RaulMedina-Estrada143/Phase_C_Deliverables/PCB Designs/PLOT/Plot/3D Render_Back.png

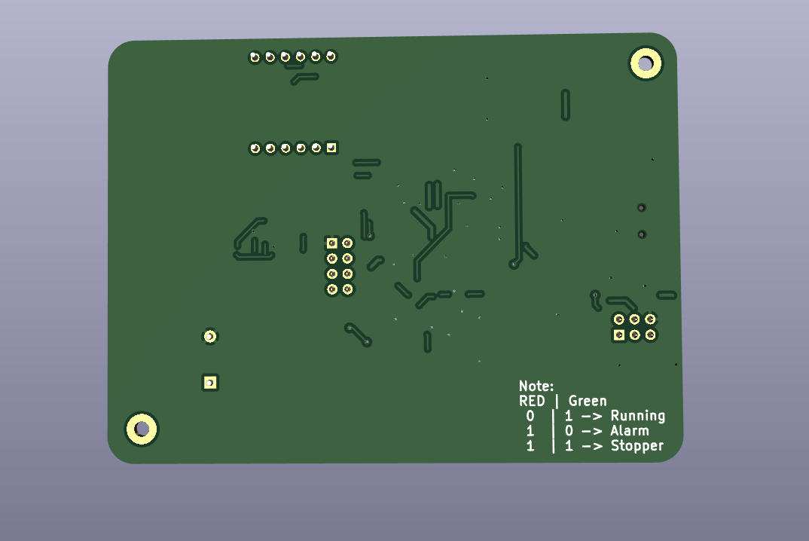
PCB Designs/PLOT/Plot/3D Render_Back.png
