RaulMedina-Estrada143/Phase_C_Deliverables/PCB Designs/PLOT/Plot/PCB_Layout.png

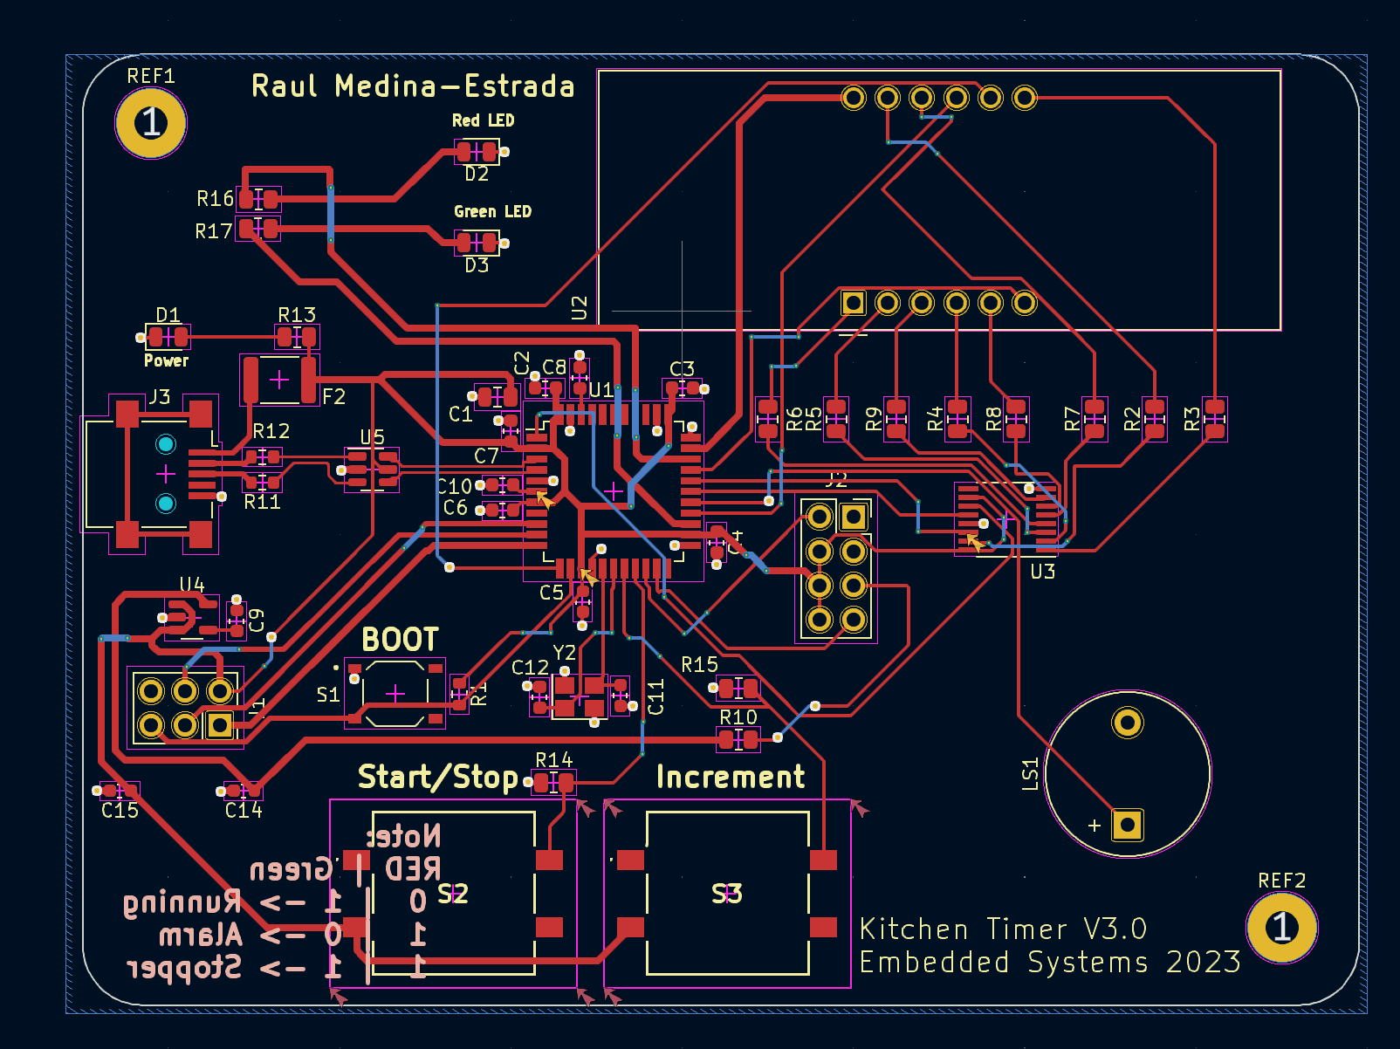
PCB Designs/PLOT/Plot/PCB_Layout.png
