RaulMedina-Estrada143/Phase_C_Deliverables/PCB Designs/PLOT/Plot/Schematic.png

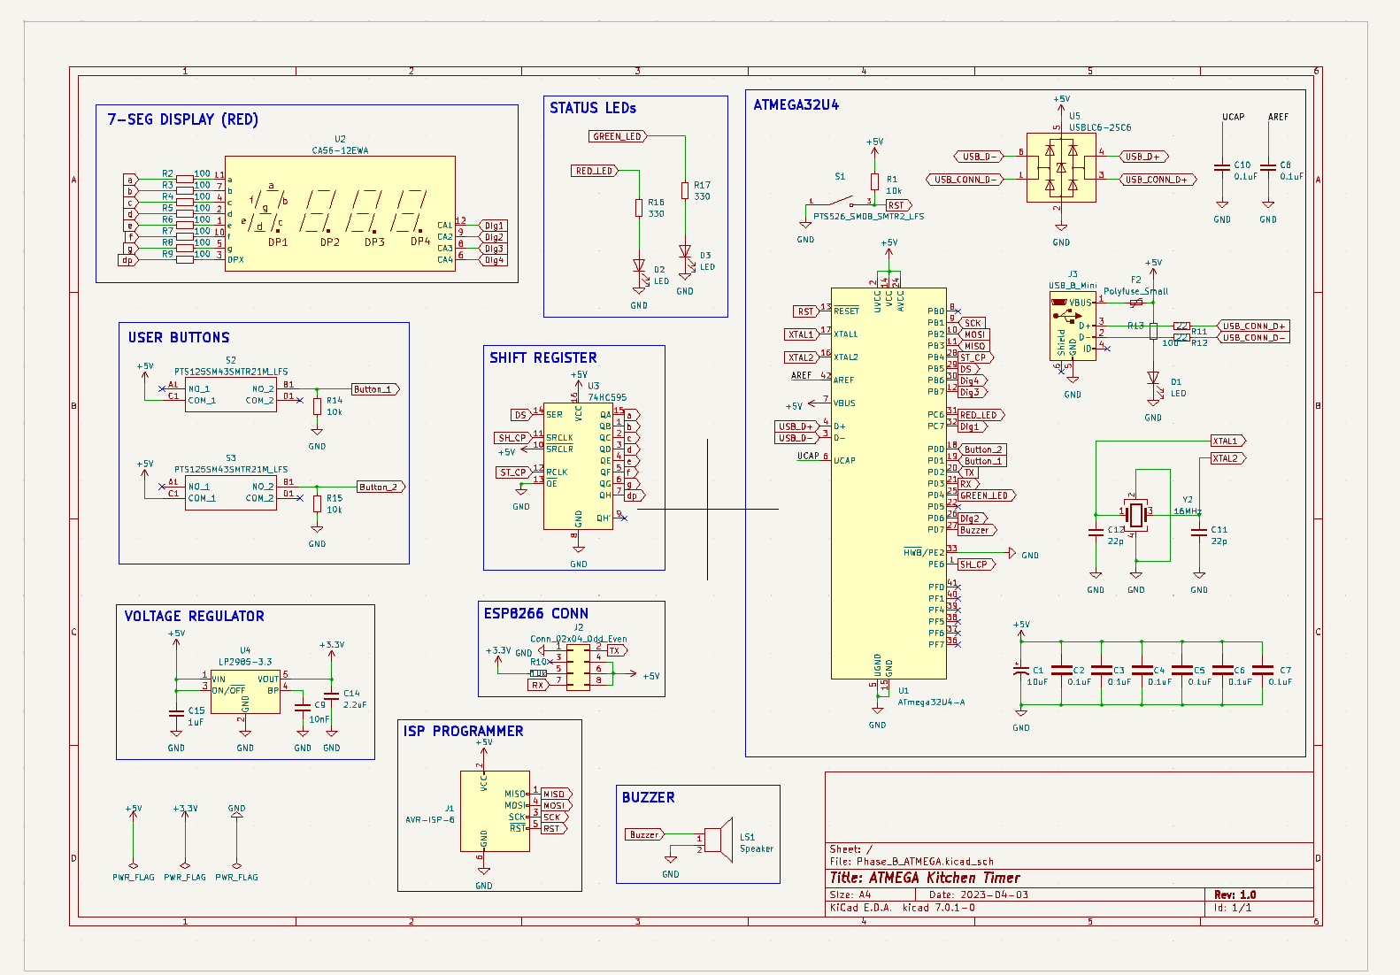
PCB Designs/PLOT/Plot/Schematic.png
