RaulMedina-Estrada143/Phase_C_Deliverables/PCB Designs/ENCLOSURE/KT_ENCLOSURE-top.STL

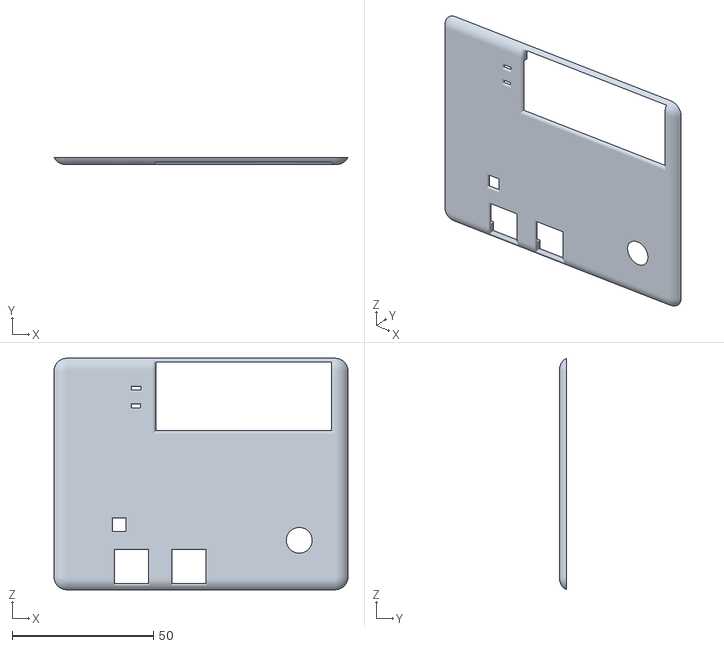
[picture p5: CAD file, 2023-06-13]
PCB Designs/ENCLOSURE/KT_ENCLOSURE-top.STL
104.1 x 2.54 x 82.0
