RaulMedina-Estrada143/Phase_C_Deliverables/PCB Designs/ENCLOSURE/KT_ENCLOSURE.STL

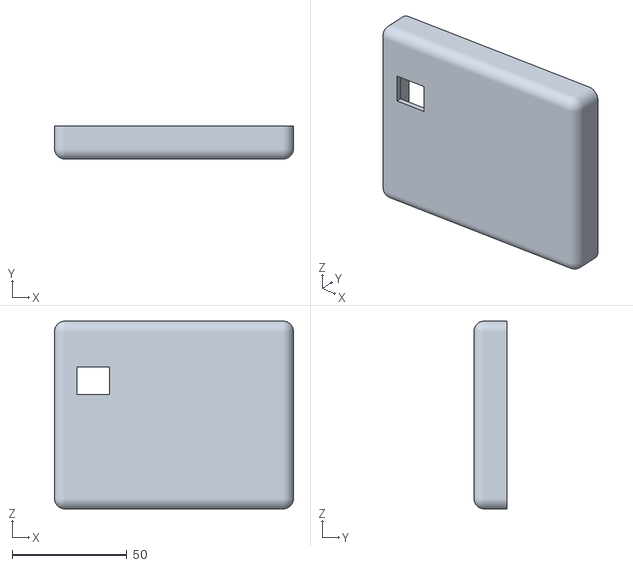
[picture p6: CAD file, 2023-06-13]
PCB Designs/ENCLOSURE/KT_ENCLOSURE.STL
104.2 x 14.5 x 81.9
