RaulMedina-Estrada143/Phase_C_Deliverables/PCB Designs/SCHEMATIC/Phase_B_ATMEGA.kicad_sch

## KiCad design PCB Designs/SCHEMATIC/Phase_B_ATMEGA.kicad_sch (2023-06-13)

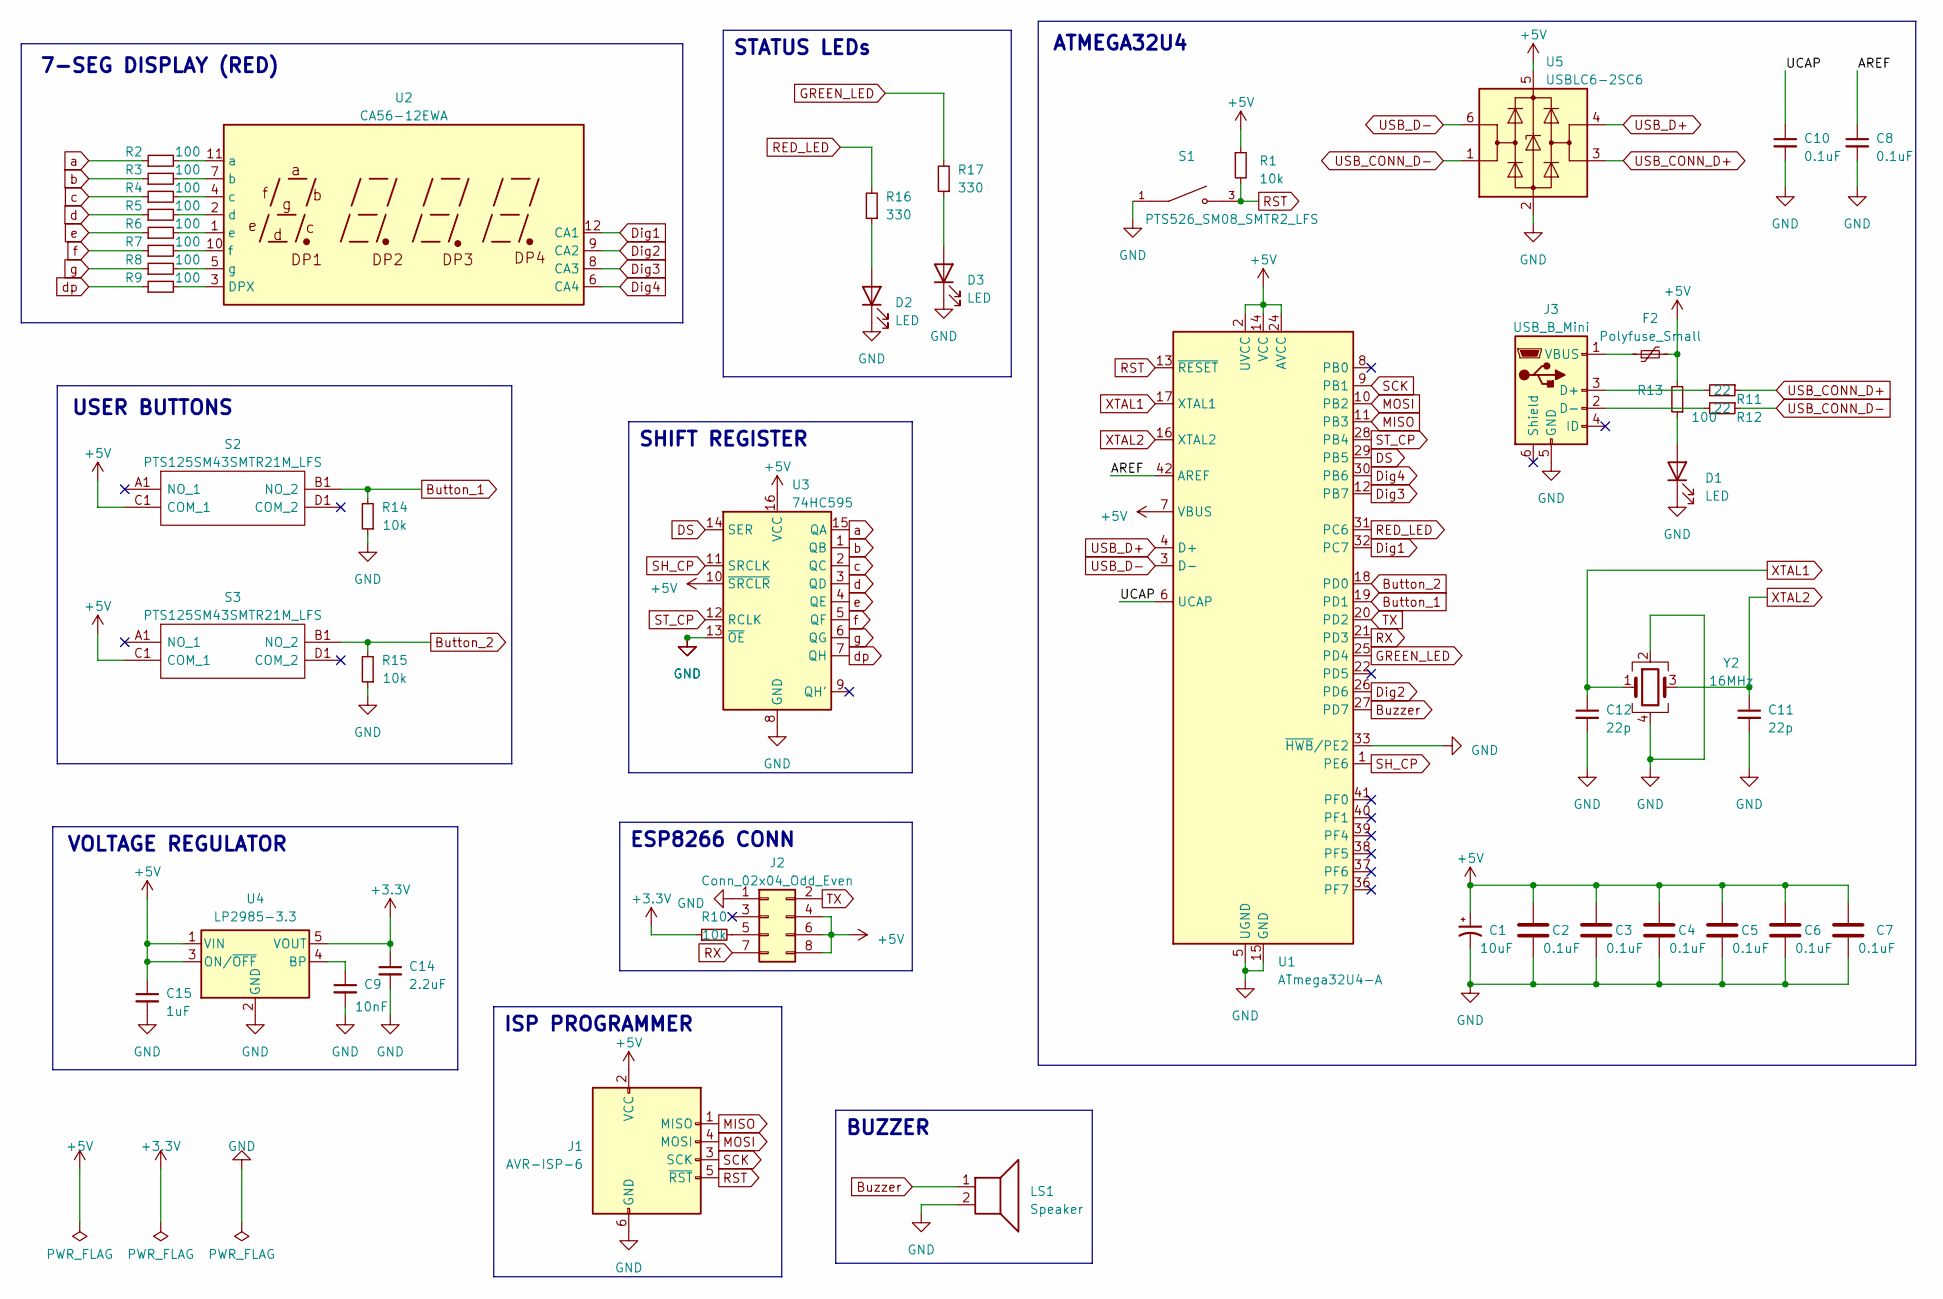
[picture p7: schematic Phase_B_ATMEGA.kicad_sch]

Parts:
C1: 10uF; C_0805_2012Metric
C2, C3, C4, C5, C6, C7, C8, C10: 0.1uF; C_0603_1608Metric
C9: 10nF; C_0603_1608Metric
C11, C12: 22p; C_0603_1608Metric
C14: 2.2uF; C_0603_1608Metric
C15: 1uF; C_0603_1608Metric
D1, D2, D3: LED; LED_0805_2012Metric
F2: Polyfuse_Small; Fuse_1812_4532Metric
J1: AVR-ISP-6; PinSocket_2x03_P2.54mm_Vertical
J2: Conn_02x04_Odd_Even; PinSocket_2x04_P2.54mm_Vertical
J3: USB_B_Mini; USB_Mini-B_Lumberg_2486_01_Horizontal
LS1: Speaker; Buzzer_12x9.5RM7.6
R1: 10k; R_0603_1608Metric
R2, R3, R4, R5, R6, R7, R8, R9, R13: 100; R_0805_2012Metric
R10, R14, R15: 10k; R_0805_2012Metric
R11, R12: 22; R_0603_1608Metric
R16, R17: 330; R_0805_2012Metric
S1: PTS526_SM08_SMTR2_LFS; PTS526_SMD_Button; PARTREV 20 mar 19
S2, S3: PTS125SM43SMTR21M_LFS; PTS125_SMD_Button; Manufacturer_Part_Number PTS125SM43SMTR21M LFS; Mouser Part Number 611-PTS125S43SMTRLFS
U1: ATmega32U4-A; TQFP-44_10x10mm_P0.8mm
U2: CA56-12EWA
U3: 74HC595; TSSOP-16_4.4x5mm_P0.65mm
U4: LP2985-3.3; SOT-23-5
U5: USBLC6-2SC6; SOT-23-6
Y2: 16MHz; Crystal_SMD_Abracon_ABM8G-4Pin_3.2x2.5mm

Connections:
+3.3V: C14.1, R10.1, U4.5 (VOUT)
+5V: C1.1, C2.1, C3.1, C4.1, C5.1, C6.1, C7.1, C15.1, F2.2, J1.2 (VCC), J2.4, J2.6, J2.8, R1.1, R13.2, S2.C1 (COM_1), S3.C1 (COM_1), U1.2 (UVCC), U1.7 (VBUS), U1.14 (VCC), U1.24 (AVCC), U1.34 (VCC), U1.44 (AVCC), U3.10 (~SRCLR), U3.16 (VCC), U4.1 (VIN), U4.3 (ON/~OFF), U5.5 (VBUS)
AREF: C8.1, U1.42 (AREF)
Button_1: R14.2, S2.B1 (NO_2), U1.19 (PD1)
Button_2: R15.2, S3.B1 (NO_2), U1.18 (PD0)
Buzzer: LS1.1, U1.27 (PD7)
DS: U1.29 (PB5), U3.14 (SER)
Dig1: U1.32 (PC7), U2.12 (CA1)
Dig2: U1.26 (PD6), U2.9 (CA2)
Dig3: U1.12 (PB7), U2.8 (CA3)
Dig4: U1.30 (PB6), U2.6 (CA4)
GND: C1.2, C2.2, C3.2, C4.2, C5.2, C6.2, C7.2, C8.2, C9.2, C10.2, C11.2, C12.2, C14.2, C15.2, D1.1 (K), D2.1 (K), D3.1 (K), J1.6 (GND), J2.1, J3.5 (GND), LS1.2, R14.1, R15.1, S1.1, U1.5 (UGND), U1.15 (GND), U1.23 (GND), U1.33 (~HWB/PE2), U1.35 (GND), U1.43 (GND), U3.8 (GND), U3.13 (~OE), U4.2 (GND), U5.2 (GND), Y2.2, Y2.4
GREEN_LED: R17.2, U1.25 (PD4)
MISO: J1.1 (MISO), U1.11 (PB3)
MOSI: J1.4 (MOSI), U1.10 (PB2)
unnamed: C9.1, U4.4 (BP)
unnamed: D1.2 (A), R13.1
unnamed: D2.2 (A), R16.1
unnamed: D3.2 (A), R17.1
unnamed: F2.1, J3.1 (VBUS)
unnamed: J2.5, R10.2
unnamed: J3.2 (D-), R12.2
unnamed: J3.3 (D+), R11.2
unnamed: R2.2, U2.11 (a)
unnamed: R3.2, U2.7 (b)
unnamed: R4.2, U2.4 (c)
unnamed: R5.2, U2.2 (d)
unnamed: R6.2, U2.1 (e)
unnamed: R7.2, U2.10 (f)
unnamed: R8.2, U2.5 (g)
unnamed: R9.2, U2.3 (DPX)
RED_LED: R16.2, U1.31 (PC6)
RST: J1.5 (~RST), R1.2, S1.3, U1.13 (~RESET)
RX: J2.7, U1.21 (PD3)
SCK: J1.3 (SCK), U1.9 (PB1)
SH_CP: U1.1 (PE6), U3.11 (SRCLK)
ST_CP: U1.28 (PB4), U3.12 (RCLK)
TX: J2.2, U1.20 (PD2)
UCAP: C10.1, U1.6 (UCAP)
USB_CONN_D+: R11.1, U5.3 (I/O2)
USB_CONN_D-: R12.1, U5.1 (I/O1)
USB_D+: U1.4 (D+), U5.4 (I/O2)
USB_D-: U1.3 (D-), U5.6 (I/O1)
XTAL1: C12.1, U1.17 (XTAL1), Y2.1
XTAL2: C11.1, U1.16 (XTAL2), Y2.3
a: R2.1, U3.15 (QA)
b: R3.1, U3.1 (QB)
c: R4.1, U3.2 (QC)
d: R5.1, U3.3 (QD)
dp: R9.1, U3.7 (QH)
e: R6.1, U3.4 (QE)
f: R7.1, U3.5 (QF)
g: R8.1, U3.6 (QG)

Notes on the sheet:
USER BUTTONS
STATUS LEDs
SHIFT REGISTER
VOLTAGE REGULATOR
ESP8266 CONN
BUZZER
7-SEG DISPLAY (RED)
ISP PROGRAMMER
ATMEGA32U4
